hrabeCesnek/Diplomka2/README.md

# Diplomka
Nothing more than destiny fullfillation
