hrabeCesnek/Diplomka2/bp_dp.tex

% -----------------------------------------------
% Styl pro psaní diplomových a bakalářských prací
% -----------------------------------------------
\documentclass[a4paper,12pt]{book} % pro oboustranný tisk zvolte {book}!
% velikost stránky
\usepackage[tmargin=2cm,bmargin=2.5cm,rmargin=2cm,lmargin=3.5cm]{geometry}
% volba kódování, nastaveno je unicode
\usepackage[utf8]{inputenc}
% \usepackage[cp1250]{inputenc}
% \usepackage[latin2]{inputenc}
\usepackage[english]{babel}
%\def\refname{Literatura}
% pomocná makra pro sazbu matematických výrazů
\usepackage{amssymb} %na psaní dvojitých písem a zvlastních znaků (např. \varkappa)
\usepackage{amsmath}
% balíček pro vkládání obrázků
\usepackage{graphicx}
\usepackage{subfig}
% balíček pro obrázky na krajích stránky 
%\usepackage{floatflt}
% balíček pro křížové odkazy
\usepackage[unicode,bookmarksopen,colorlinks=false,plainpages=false,urlcolor=blue,pdfpagelabels]{hyperref}
% balíček pro vkládání hypertextových odkazů
\usepackage{url}
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
\ifbakal%
  \newcommand{\program}{B0533A110007  Applied Physics}%
  \newcommand{\obor}{1702R001  Applied Physics  (AFYZ)}%
  \else%
  \newcommand{\program}{N0533A110002 Applied Physics}%
  \newcommand{\obor}{1702T001 Applied Physics  (AFYZ)}%  

\fi
\newcommand{\rokod}{2024}
\newcommand{\vedouci}{Mgr. Aleš Stejskal Ph.D.}
\newcommand{\konzultant}{Mgr. Leo Schlattauer Ph.D.}

\newcommand{\abstrakt}{%
Tato práce je věnována vývoji polovodičového detektoru pro nízkoenergetické gamma fotony. Popisuje testování PIN fotodiod, vývoj analogových elektornických obvodů pro gamma a Mössbauerovu spektroskopii a taktéž se zabývá komparačními měřeními mezi polovodičovými detektory a jinými typy detektorů.}
% -----------------------------------------------
\newcommand{\abstrakten}{%
This thesis is dedicated to the development of
of semiconductor detectors for low energy gamma photons. It describes the testing of PIN photodiodes, the development of analog electronic circuits for the purposes gamma and Mössbauer spectroscopy and also deals with comparative measurements between semiconductor detectors and other types of detectors.}
% klíčová slova
\newcommand{\klic}{PIN fotodioda, PCB, MS, gamma spektrum, předzesilovač}
\newcommand{\klicen}{PIN photodiode, PCB, MS, gamma spectrum, preamplifier}
\newcommand{\pocetstran}{	
\pageref{LastPage}}
\newcommand{\pocetpriloh}{1}

% -----------------------------------------------
% Definice vlastních maker pro usnadnění psaní
% a opakování symbolů při zlomu řádku
% -----------------------------------------------
% implikace se opakuje
\def\Plyne{\Rightarrow\discretionary{}{\hbox{$\Rightarrow$}}{}}
% -----------------------------------------------
% ekvivalence se opakuje
\def\Ekviv{\Leftrightarrow\discretionary{}{\hbox{$\Leftrightarrow$}}{}}
% -----------------------------------------------
% % plus '+' se opakuje při zalomení řádku
\mathchardef\plus="202B
\mathcode`\+="8000
{\catcode`\+=\active
\gdef+{\plus\nobreak\discretionary{}{\hbox{$\plus$}}{}}}
% opakování - při zalomení řádku
\newsavebox{\minusbox}
\savebox{\minusbox}{\hbox{$-$}}
\def\aktivniminus #1{{\catcode`#1=13 \bgroup \uccode`~=`#1
\uppercase{\egroup\gdef~}{\mathminus\discretionary{}{\copy\minusbox}{}}}}
% % -----------------------------------------------
% % rovnitko '=' se opakuje
\def\aktivnirovnitko #1{{\catcode`#1=13 \bgroup \uccode`~=`#1
\uppercase{\egroup\gdef~}{\mathequal\discretionary{}{=}{}}}}
% -----------------------------------------------
% zrušení mezery za čárkou v matematickém reľimu
\mathcode`,="002C

% -----------------------------------------------
% Úprava matematické sazby
% -----------------------------------------------
\def\sgn{\mathop{\rm sgn}\nolimits}
\def\tg{\mathop{\rm tg}\nolimits}
\def\cotg{\mathop{\rm cotg}\nolimits}
\def\arctg{\mathop{\rm arctg}\nolimits}
% -----------------------------------------------
% vektory polotučným skloněným písmem
\DeclareFontFamily{OT1}{bssbf}{}
\DeclareFontShape{OT1}{bssbf}{m}{n}{<5> <6> <7> <8> <9> <10> <11> <12> <14.4> <17> <20> <20.74> <25> bssb10}{}
\newcommand{\vek}{\fontencoding{OT1}\fontfamily{bssbf}\selectfont}
\renewcommand{\vec}[1]{\hbox{\vek #1}\hspace*{1.5pt}}
% polotučná řecká písmena
\def\bgomega{\vec{\char151}}
     \def\bgOmega{\vec{\char10}}
     \def\bggamma{\vec{\char130}}
     \def\bgvarphi{\vec{\char161}}
     \def\bgphi{\vec{\char148}}
     \def\bgxi{\vec{\char142}}
     \def\bgtau{\vec{\char146}}
     \def\bgeta{\vec{\char134}}
     \def\bgmu{\vec{\char139}}
     \def\bgnu{\vec{\char140}}
     \def\bvarrho{\vec{\char157}}
     \def\bgsigma{\vec{\char145}}
     \def\bgpsi{\vec{\char150}}
     \def\bgchi{\vec{\char149}}
     \def\bgvartheta{\vec{\char154}}
%\renewcommand{\thefigure}{\arabic{figure}}
%\renewcommand{\theeuqation}{\arabic{euqation}}

\raggedbottom %přidaný kvůli špatnýmu řádkování
% ---------------------------------------------------------------
% Samotná práce
% ---------------------------------------------------------------
\begin{document}

% -----------------------------------------------
% Titulní strana
% -----------------------------------------------
\pagestyle{empty}
\setbox0=\hbox{\LARGE\scshape Joint Laboratory of Optics}
\centerline{\LARGE\scshape  Palacký University Olomouc}

\bigskip
\centerline{\LARGE\scshape Faculty of Science}
   
\bigskip
\centerline{\box0}
  
\vfill
\centerline{\LARGE\bfseries \ifbakal{BACHELOR}\else{MASTER}\fi\ THESIS}

\bigskip
\begin{center}
{\huge\nazev}  

\vfill
\ifbarva\else%
\fi

\vfill

\noindent%
\begin{tabular}{ll}
Author\ifstudentka{a}\fi: & {\bfseries\student}\\
Study program: &\program\\
Field of study: &\obor\\
Form of study:& Full-time\\
Supervisor:& \vedouci\\
Deadline:& May~\rokod
\end{tabular}
\end{center}
%----Vdek------------------------------------------------------
\newpage
\hbox{~}

\vfill
\noindent

I would like to thank my supervisor Mgr. Aleš Stejskal Ph.D. for his support, guidance and feedback during the whole process of writing this thesis. I would also like to thank my former supervisor Mgr. Leo Schlattauer Ph.D. for the necessary support at the very beginning of the work on the experimental part of this thesis.

% ---------------------------------------------------------------
% Prohlášení
% -----------------------------------------------
\newpage
\hbox{~}

\vfill

\begin{center}
{\bf DECLARATION}
\end{center}

\noindent
I hereby declare that I elaborated this master thesis independently under the supervision 
of Mgr. Aleš Stejskal Ph.D.,  using  only  information  sources  referred  in  the  Literature chapter. \\
{}\vspace{3ex}

\noindent
In~Olomouc~\today   \hfill\parbox[t]{6cm}{\centering\null\dotfill\\\student}

% -----------------------------------------------
% Bibliografická anotace
% -----------------------------------------------
\newpage
\input{bibl_identifikace}

%%%% Tady začínáme %%%%%%%%%%%%%%%%%%%%%%%%%%%%%%%%%%%%%%%%%%%%%%%%%%%%%%%%%%
\newpage
%%%%%%%%%%%%%%%%%%%%%%%%%%%%%%%%%%%%%%%%%%%%%%%%%%%%%%%%%%%%%%%%%%%%%%%%%%%%%
\widowpenalty =10000
\pagestyle{plain}
\let\cleardoublepage\clearpage %odstanění dvojitých stran
% -----------------------------------------------
% Obsah je generován automaticky, změny se projeví po 2 překladech
% -----------------------------------------------
\tableofcontents

% -----------------------------------------------
% Úvod
% -----------------------------------------------
\chapter*{Introduction}
\addcontentsline{toc}{chapter}{Introduction}
In nuclear and particle physics, semiconductor-based detectors are becoming increasingly common due to the many unique properties they offer. Semiconductor detectors have a very wide range of applications, from spectroscopy to large particle experiments such as ATLAS at CERN.  

\par
This thesis is dedicated to the development of a semiconductor detector based on a Si photodiode for the detection of low energy gamma photons. The detection of low-energy gamma photons plays a crucial role in the field of Mössbauer spectroscopy, which requires a detector with sufficient detection efficiency and energy resolution.
\par
The first four chapters are theoretical and provide a brief introduction to the mechanisms of gamma photon interaction and detection, the properties of semiconductor detectors and the basics of Mössbauer spectroscopy. These chapters are followed by a chapter describing the specifications of nuclear instruments used to build a spectrometric chain, and then a chapter introducing the numerical analysis of gamma energy spectra. 

\par
The experimental part begins with the gamma detection tests of selected photodiodes and is followed by a chapter filled with the technical description of the printed circuit board (PCB) integration of the spectrometric chain. The thesis ends with two chapters presenting the results of gamma energy spectra and Mössbauer spectra measurements.

% -----------------------------------------------
% Kapitoly lze ukládat do zvláštních souborů...
% -----------------------------------------------

% -----------------------------------------------
\input{gammaRays}

\input{detectors}

\input{Semiconductors}

\input{Mossbauer}

\input{pulseAnalysis}

\input{Algorytms}

\input{PINtesting}

\input{PCBconstruct}

\input{PCBmeas}

\input{MossMeas}

% -----------------------------------------------
% Závěr
% -----------------------------------------------
\chapter*{Discussion}
\addcontentsline{toc}{chapter}{Discussion}
The development of the PIN detector for transmission MS spectroscopy can be continued by using photodiodes with better detection efficiency - by using a Si photodiode with greater thickness or by using a photodiode made of another material with higher $Z$ (e.g. Ge). To fully observe the 6.4 keV energy peak, it will be necessary to use a photodiode with lower capacitance (greater thickness also implies lower capacitance) or a preamplifier with better characteristics. This optimised preamplifier can be realised using discrete opamps. The development can also be continued by mathematical modelling of a better semiconductor detector for MS and by a theoretical simulation of its detection efficiency, using some of the well-known programs for simulating the passage of particles through matter, such as the Geant4 \cite{Geant4}.
\par
The semiconductor detector with a larger detection area can be made up of several PIN photodiodes. However, to reduce noise, each photodiode must have its own preamplifier and amplifier. The final aim is to build a compact Mössbauer spectrometer for backscattering geometry by combining several Si PIN photodiodes with a small transducer in one instrument.
%The development of PIN detector for transmission MS spectroscopy can continue by employing the photodiodes with better detection efficiency - by using Si photodiode with greater thickness or by using a photodiode made of a different material with higher $Z$ (for example Ge). To fully observe 6.4 keV energy peak, it will be necessary to employ a photodiode with lesser capacitance (greater thickness also implies lesser capacitance) or a preamplifier with a better characteristics. The development can also go on by the mathematical modelling of a better semiconductor detector for MS and by a theoretical simulations of its detection efficiency by using some of well-known programs for the simulation of passage of particles through matter such as the Geant4 \cite{Geant4}.
%\par
%The semiconductor detector with greater detection area can be constructed from multiple PIN photodiodes. However, to reduce noise, it is necessary that each photodiode have its own preamplifier and amplifier. Final goal is then to assemble the compact Mössbauer spectrometer for backscattering geometry by combining multiple Si PIN photodiodes and a small transducer into one instrument.

\chapter*{Conclusion}
\addcontentsline{toc}{chapter}{Conclusion}
The first tests of the SI PIN photodiodes were performed on a setup consisting of ORTEC modular parts. All three selected photodiodes (S14605, BPW34 and OPF430) produced spectrometric pulses and the gamma spectra of $^{57}$Co were successfully measured and interpreted. Characteristic full energy peaks of $^{57}$Co (14.4 keV, 122.1 keV and 136.5 keV) were observed, as well as the expected Compton continuum resulting from Compton scattering of 122.1 keV inside the detector. It was found that electromagnetic shielding plays a very important role in noise reduction. The Si PIN photodiodes attached to the charge preamplifier cannot operate properly without sufficient shielding. Cooling the photodiode also had an effect, but it was much less significant.
\par
It was shown that even a cheap Si PIN photodiode (BPW34 and OPF430), originally designed for light detection, could be used as a detector for gamma spectroscopy. However, it has been shown that their detection efficiency is much lower than that of the S14605 photodiode, which is classified as an X-ray detector.
\par
The analog front-end electronics, based on the Cremat preamplifier and shaper, has been successfully developed. It requires only a +15V and -15V power supply to operate. Its output can be connected directly to the MCA. The MS measurement setup using the constructed Si PIN detector was successfully assembled and the transmission MS spectra of a singlet sample were successfully measured.
\par
Two types of measurements were performed to compare the Si PIN detector with the gas and scintillator detector - the 14.4 keV relative detection efficiency measurement and the MS measurement. The only parameter of the Si PIN detector that can be characterised as the best among the detectors tested is the effect of the measurement.
%The first tests of Si PIN photodiodes were performed on setup consisting of ORTEC modular parts. All the three selected photodiodes (S14605, BPW34 and OPF430) produced spectrometric pulses and the gamma spectra of $^{57}$Co were successfully measured and interpreted. Characteristic full energy peaks of $^{57}$Co (14.4 keV, 122.1 keV and 136.5 keV) were observed as well as expected Compton continuum originating from Compton scattering of 122.1 keV inside the detector. It was found out, that the electromagnetic shielding plays a very important role in noise reduction. The Si PIN  photodiodes attached to charge preamplifier can not work properly without sufficient shielding. Cooling the photodiode also had an effect, but its significance was much lower.
%\par
%It was proven, that even a cheap Si PIN photodiode (BPW34 and OPF430) originally intended for detection of light can be employed as detector for gamma spectroscopy. However, it was shown that their detection efficiency is much worse than the detection efficiency of photodiode S14605, which is classified as X-ray detector.
%\par
%The front-end analog electronics based on Cremat preamplifer and shaper was successfully developed. For its functionality it requires only +15 V and -15 V power supply. Its output can be directly routed to the MCA. The MS measurement setup employing constructed Si PIN detector was successfully assembled and the transmission MS spectra of a singlet sample was successfully measured.
%\par
%Two types of measurements were performed in order to compare the Si PIN detector with gaseous and scintillator detector - the measurement of 14.4 keV realative detection efficiency and the MS measurement. The only parameter of the Si PIN detector, which can be characterized as the best among the tested detectors is effect of measurement.

% -----------------------------------------------
% Literatura a prameny
% -----------------------------------------------
%\begin{thebibliography}{99}
%\bibliographystyle{unsrt}
%\nocite{*}
%\bibliography{citations}
%\nocite{MALACARI2020102430}
%\nocite{*}
%\nocite{Tomankova2016_1000061954}
%\nocite{VACULA2021167169}
%\addcontentsline{toc}{chapter}{Literatura}
%\bibitem{gravitation} MISNER, Ch. W.; THORNE, K. S.; WHEELER, J. A. %\emph{Gravitation}. San Francisco: W. Freeman, 1973.
%\end{thebibliography}
%\printbibliography
\printbibliography[notcategory=skipbibliography]
%\newpage
%\chapter*{Attachment: Measurement and analysis programs}
%Measurement folder - scripts for controlling measurement
%\newline
%PulseAnalysis folder - scripts for PMT pulse analysis
%\newline
%FASTanalyze.cpp - calibration data analysis
%\newline
%main.c - Nucleo F446RE's synchronized sampling and PID regulator firmware
\chapter*{List of Symbols and Abbreviations}
\begin{table}[H]
\begin{tabular}{l l}
$\sigma$ & cross section \\
$\sigma_{\textrm{A}}$ & cross section of single atom \\
$F_{\textrm{part}}$ & particle flux \\
$N_{\textrm{s}}$ & average number of particles scattered per unit time from single point target \\
$\Omega$ & solid angle\\
$A$ & area perpendicular to the flux\\
$N_{\textrm{i}}$ & density of interaction centres \\
$N_{\textrm{sc}}(\Omega)$ & average number of particles scattered per unit time multiple interaction centres \\
$N_{\textrm{tot}}$ & average number of particles scattered per unit time multiple interaction centres \\
& integrated over entire solid angle \\
$\delta x$ & material thickness \\
$Z$ & atomic number \\
$I_{\textrm{T}}$ & transmitted radiation intensity\\
$I_{\textrm{0}}$ & incident radiation intensity\\
$\mu$ & total absorption coefficient\\
$N_{\textrm{d}}$ & atomic density \\
$N_{\textrm{a}}$ & Avogadro number \\
$\rho$ & material density \\
$A_{\textrm{w}}$ & molecular weight \\
$f$ & photon frequency \\
$h$ & Planck's constant \\
$\hbar$ & reduced Planck's constant \\
$E_{\textrm{e}}$ & kinetic energy of free electron \\
$E_{\textrm{b}}$ & binding energy of electron \\
$E_{\textrm{2}}$ & scattered photon energy \\
$E_{\textrm{1}}$ & initial photon energy \\
$m_{\textrm{e}}$ & electron mass \\
$M$ & heavy charged particle mass \\
$c$ &  speed of light in vacuum\\
$\frac{dE}{dx}$ &  stopping power\\
$\theta$ &  scattering angle \\
$\varphi$ &  maximum scattering angle \\
$E_{\textrm{c}}$ & energy of electron inside crystal\\
$E_{\textrm{c}}(\vec{k})$ & energy dispersion relation\\
$\vec{k}$ & wave vector \\
$E_{\textrm{g}}$ & energy gap\\
$E_{\textrm{T}}$ & thermal energy\\
$E_{\textrm{s}}$ & electrostatic energy\\
$E_{\textrm{photon}}$ & photon energy\\

\end{tabular}
 \label{symbols}
\end{table}

\newpage
\begin{table}[H]
\begin{tabular}{l l}
$E_{\textrm{F}}$ & Fermi level energy\\
$k$ & Boltzmann constant\\
$\phi$ & electrostatic potential\\
$T$ & thermodynamic temperature \\
$t$ & temperature (Celsius scale)\\
$\omega_{\textrm{photon}}$ & photon angular frequency \\
$E_{\textrm{gamma}}$ & incident gamma photon energy \\
$\epsilon$ & average energy for electron-hole pair generation \\
$n$ & number of generated electron-hole pairs \\
$E$ & energy of incoming particle \\
$F$ & Fano factor \\
$U_{\textrm{R}}$ & reverse voltage \\
$E_{\textrm{0}}$ & base energy level of nucleus\\
$E_{\textrm{M}}$ & pertubed energy level of nucleus\\
$Q_{\textrm{n}}$ & quadrupole momentum of nucleus\\
$m$ & nuclear magnetic number\\
$I_{\textrm{n}}$ & spin of nucleus\\
$E_{\textrm{Q}}$ & energy variation with respect to magnetic quantum number\\
$\gamma$ & gyromagnetic ratio\\
$\delta$ & isomer shift\\
$\mu_{\textrm{m}}$ & magnetic momentum of nucleus\\
$L_{\textrm{v}}$ & Lorentzian in MS spectrum\\
$v$ & relative velocity of radiation source and MS sample \\
$v_0$ & resonant velocity \\
$A$ & area under Lorentzian \\
$\Gamma$ & FWHM of Lorentzian\\
$I_{\textrm{MS}}$ & amplitude of Lorentzian\\
$B$ & MS background level \\
$E_{\textrm{MS}}$ & MS effect of measurement \\
SNR$_{\textrm{MS}}$ & MS signal to noise ratio \\
$Q$ & charge \\
$U$ & voltage \\
$I$ & current \\
$I_{\textrm{G}}$ & FET gate current \\
$I_{\textrm{D}}$ & dark current \\
$C_{\textrm{f}}$ & feedback capacitance \\
$R_{\textrm{f}}$ & feedback resistance \\
$G$ & gain \\
$en_{1}$ & thermal noise of the first stage FET \\
$en_{2}$ & thermal noise caused by feedback resistance \\
$in$ & shot noise \\
$noise$ & total noise \\
$\omega$ & signal angular frequency\\
$j$ & complex unit \\
$g_{\textrm{m}}$ & FET transconductance \\
$\tau$ & decay constant\\
$U_{\textrm{A}}$ & pulse amplitude\\
$C_{\textrm{in}}$ & input capacitance \\
$C_{\textrm{j}}$ & detector capacitance \\

\end{tabular}
 \label{symbols2}
\end{table}

\newpage
\begin{table}[H]
\begin{tabular}{l l}

$C_{\textrm{s}}$ & amplifier input capacitance \\
$d$ & collimator diameter \\
$I_{\textrm{rec}}$ & recalculated amplitude of Lorentzian\\
$I_{\textrm{original}}$ & original amplitude of Lorentzian\\
$\Gamma_{\textrm{ref}}$ & original FWHM of Lorentzian\\
FWHM$_{\textrm{CR-100}}$ & FWHM limit given by CR-110 \\
FWHM$_{14.4}$ & FWHM of the 14.4 keV peak \\
FWHM$_{\textrm{Fano}}$ & FWHM given by fano noise \\

\end{tabular}
 \label{symbols3}
\end{table}

\begin{table}[H]
\begin{tabular}{l l}

PCB & printed circuit board \\
SNR & signal to noise ratio \\
PMT & photomultiplier tube \\
DEP & Department of Experimental Physics \\
MCA & multichannel analyser \\
APD & avalanche photodiode \\
CCD & charge-coupled device\\
CMOS & complementary metal–oxide–semiconductor\\
FWHM & full width at half maximum\\
GND & ground\\
YAP(Ce) & yttrium aluminium perovskite dopped by cerium\\
MS & Mössbauer spectroscopy\\
MPC & model predictive control \\
PID & proportional–integral–derivative\\

\end{tabular}
 \label{shorts}
\end{table}

\chapter*{Appendix}
\section*{Schematic and layout of the integrated amplifier}
Full EAGLE schematic and layout are in the folder IntegratedAmplifier. 

\begin{figure}[H]
 \centering
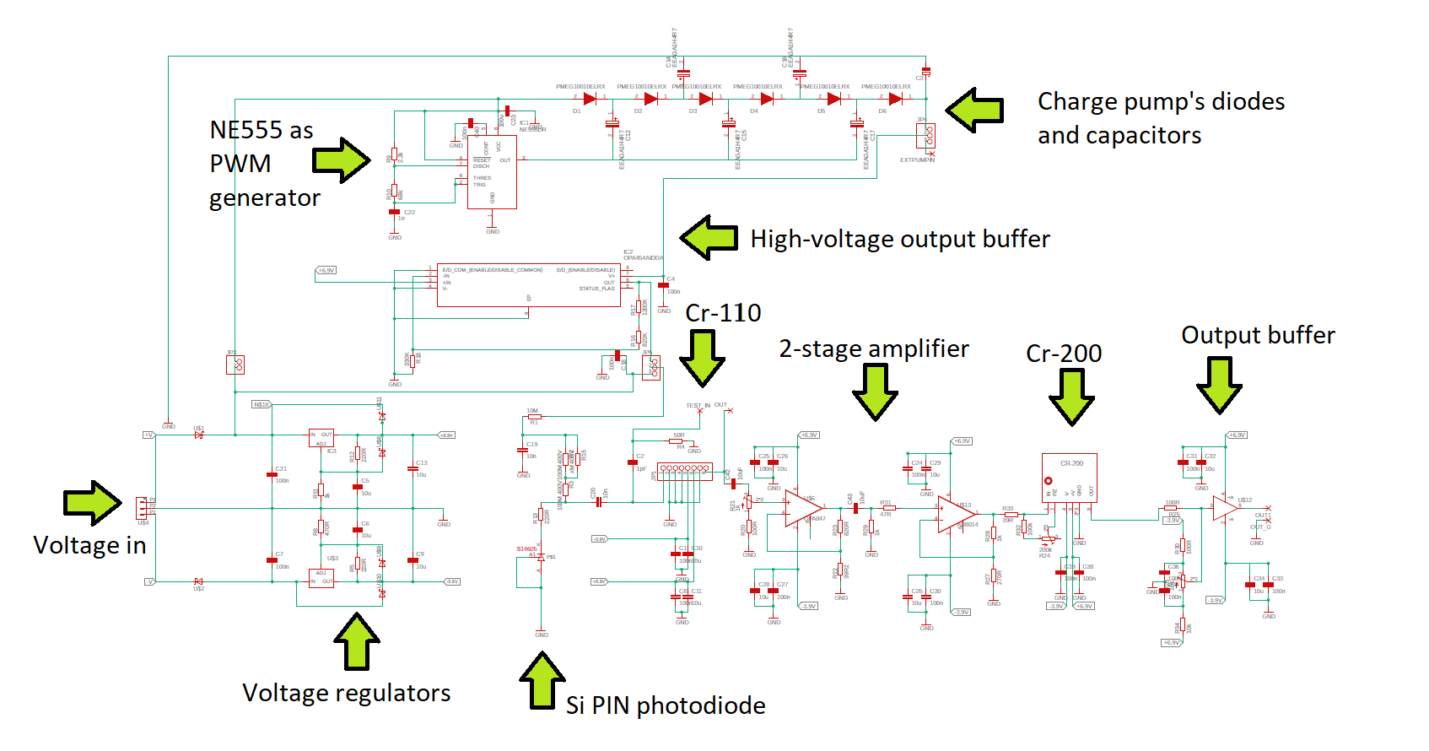
[picture p1: pictures/schemaPopis.png]
 
 \caption*{Schematic of integrated amplifier.}
 \label{schematic}
 
\end{figure}

\begin{figure}[H]
 \centering
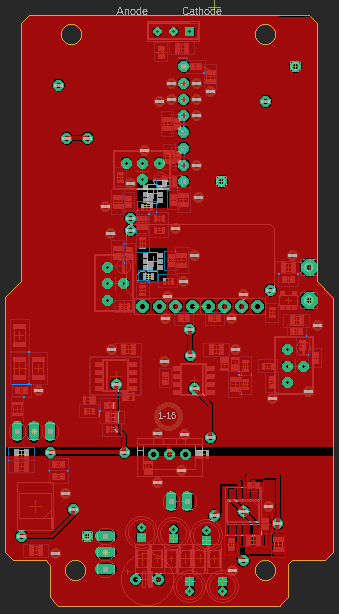
[picture p2: pictures/S14topLay.png]
 
 \caption*{Layout of integrated amplifier, top side layer.}
 \label{layout top}
 
\end{figure}

\begin{figure}[H]
 \centering
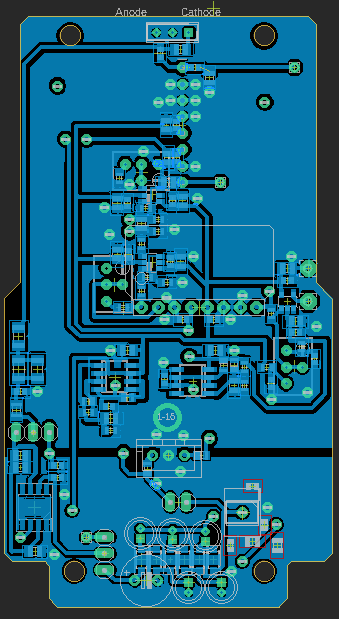
[picture p3: pictures/S14bottomLay.png]
 
 \caption*{Layout of integrated amplifier, bottom side layer.}
 \label{layout bottom}
 
\end{figure}

\section*{Peak searching program}
File SpectreAnalyzer.cpp: C++ program for automatic searching of peaks in spectrum.

\end{document}
% Konec souboru %%%%%%%%%%%%%%%%%%%%%%%%%%%%%%%%%%%%%%%%%%%%%%%%%%%%%%%%%%%%
