hrabeCesnek/Diplomka2/bibl_identifikace.tex

% Bibliografická identifikace
\section*{Bibliografická identifikace}

\begin{tabular}{lp{8.5cm}}
%-----------
% \multicolumn{2}{c}{\bfseries Bibliografická identifikace}\\[8mm]
%-----------
Jméno a příjmení autora & \student\\
%-----------
Název práce & \nazevcz \\
%-----------
Typ práce & \ifbakal{Bakalářská}\else{Diplomová}\fi \\
%-----------
Pracoviště & Společná laboratoř optiky \\
%-----------
Vedoucí práce & \vedouci\\
%-----------
Konzultant & \konzultant\\
%-----------
Rok obhajoby práce & \rokod\\
%-----------
Abstrakt & \abstrakt\\
%-----------
Klíčová slova & \klic\\
%-----------
Počet stran & \pocetstran\\
%-----------
Počet příloh & \pocetpriloh\\
%-----------
Jazyk & anglický\\
%-----------
\end{tabular}

% -----------------------------------------------

\newpage
\section*{Bibliographical identification}

\begin{tabular}{lp{8cm}}
%-----------
% \multicolumn{2}{c}{\bfseries Bibliographical identification}\\[8mm]
%-----------
Autor's first name and surname & \student\\
%-----------
Title & \nazev\\
%-----------
Type of thesis & \ifbakal{Bachelor}\else{Master}\fi \\
%-----------
Department & Joint Laboratory of Optics \\
%-----------
Supervisor & \vedouci\\
%-----------
Consultant & \konzultant\\
%-----------
The year of presentation & \rokod \\
%-----------
Abstract & \abstrakten\\
%-----------
Keywords & \klicen\\
%-----------
Number of pages & \pocetstran\\
%-----------
Number of appendices &  \pocetpriloh\\
%-----------
Language & english\\
%-----------
\end{tabular}
% %%%%%%%%%%%%%%%%%%%%%%%% End of file %%%%%%%%%%%%%%%%%%%%%%%%
