hrabeCesnek/Diplomka2/bibl_identifikaceORIG.tex

% Bibliografická identifikace
\section*{Bibliografická identifikace}

\begin{tabular}{lp{8.5cm}}
%-----------
% \multicolumn{2}{c}{\bfseries Bibliografická identifikace}\\[8mm]
%-----------
Jméno a příjmení autora & \student\\
%-----------
Název práce & \nazev \\
%-----------
Typ práce & \ifbakal{Bakalářská}\else{Diplomová}\fi \\
%-----------
Pracoviště & Katedra experimentální fyziky \\
%-----------
Vedoucí práce & \vedouci\\
%-----------
Rok obhajoby práce & \rokod\\
%-----------
Abstrakt & \abstrakt\\
%-----------
Klíčová slova & \klic\\
%-----------
Počet stran & \pocetstran\\
%-----------
Počet příloh & \pocetpriloh\\
%-----------
Jazyk & český\\
%-----------
\end{tabular}

% -----------------------------------------------
\newpage
\section*{Bibliographical identification}

\begin{tabular}{lp{8cm}}
%-----------
% \multicolumn{2}{c}{\bfseries Bibliographical identification}\\[8mm]
%-----------
Autor's first name and surname & \student\\
%-----------
Title & \nazeven\\
%-----------
Type of thesis & \ifbakal{Bachelor}\else{Master}\fi \\
%-----------
Department & Department of Experimental Physics \\
%-----------
Supervisor & \vedouci\\
%-----------
The year of presentation & \rokod \\
%-----------
Abstract & \abstrakten\\
%-----------
Keywords & \klicen\\
%-----------
Number of pages & \pocetstran\\
%-----------
Number of appendices &  \pocetpriloh\\
%-----------
Language & czech\\
%-----------
\end{tabular}
% %%%%%%%%%%%%%%%%%%%%%%%% End of file %%%%%%%%%%%%%%%%%%%%%%%%
