hrabeCesnek/Diplomka2/other materials/sensors overview.ods

type | Type | Area [mm] | Reverse voltage [V] | Depletion layer [mm] | Dark current [nA] | Capacitance [pF]
S13993 | Direct PIN | 10x10 | 100 | 0.3 | 2 | 60
S14605 | Direct PIN | 9x9 | 70 | 0.5 | 8 | 40
S8559 | Scintillator CsI | 5.8x5.8 | 5 | - | 0.05 | 950
S8193 | Scintillator CsI | 5.8x5.8 | 5 | - | 0.05 | 950
