hrabeCesnek/Diplomka2/up_logo_bw.pdf

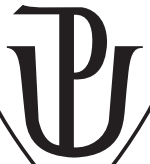
[picture p34: figure]
