hrabeCesnek/Diplomka2/up_logo_color.pdf

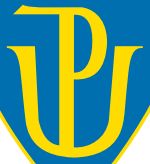
[picture p35: figure]
