hrabeCesnek/Diplomka2/pictures/chlazeniLedem.jpg

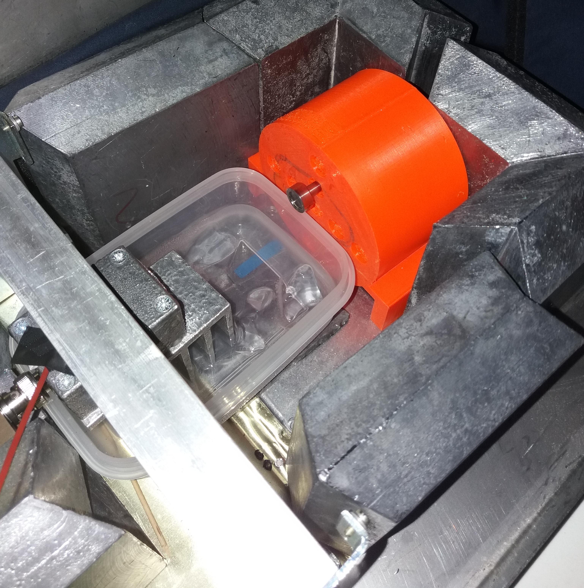
pictures/chlazeniLedem.jpg
