hrabeCesnek/Diplomka2/pictures/GASdet.png

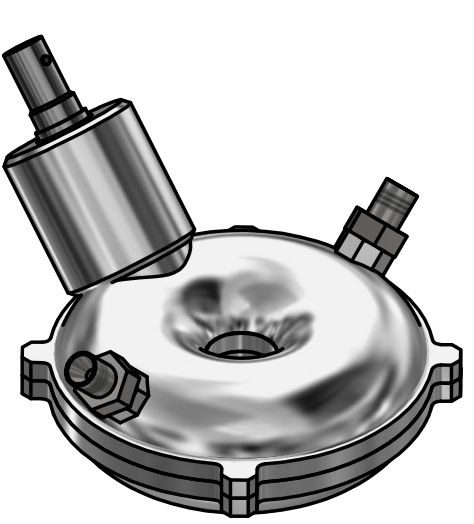
pictures/GASdet.png
