hrabeCesnek/Diplomka2/pictures/linearAttenuation.png

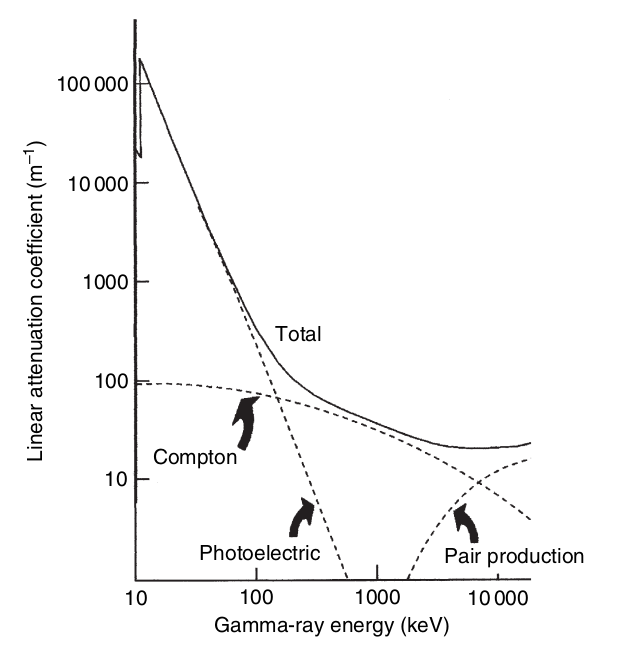
pictures/linearAttenuation.png
