hrabeCesnek/Diplomka2/pictures/PINdiodes.jpg

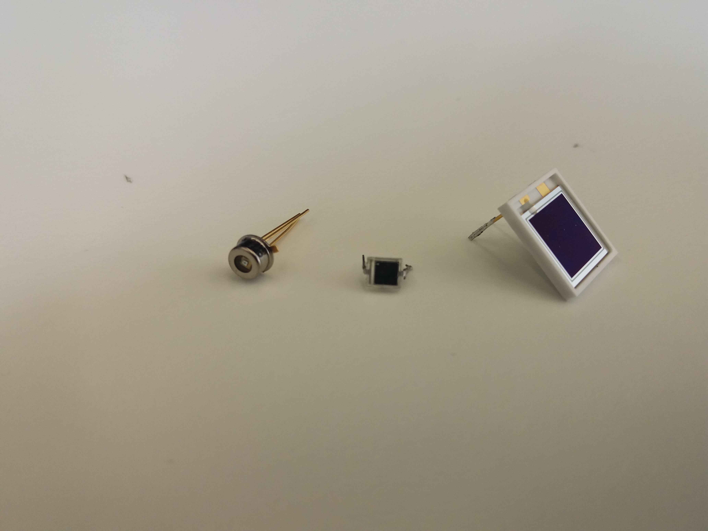
pictures/PINdiodes.jpg
