hrabeCesnek/Diplomka2/pictures/schema.png

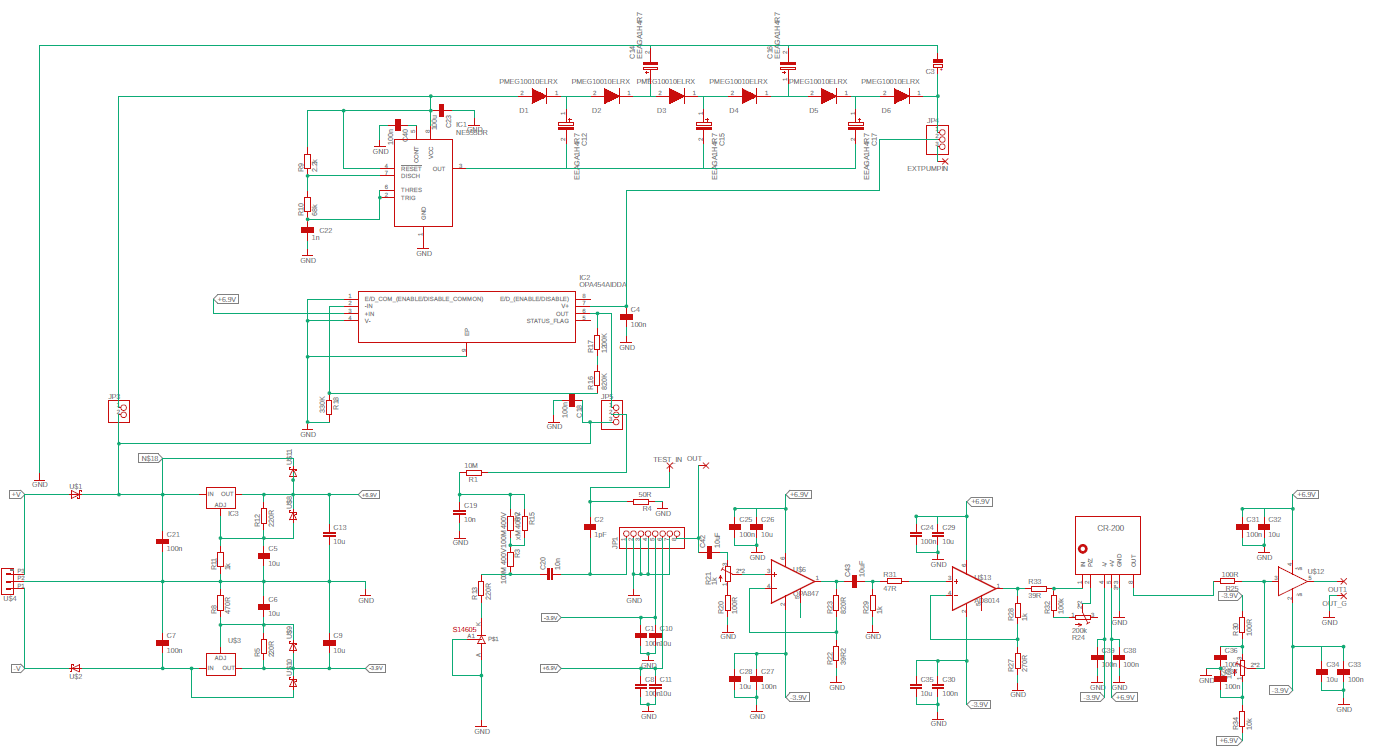
pictures/schema.png
