hrabeCesnek/Diplomka2/pictures/trash/DataGraph.png

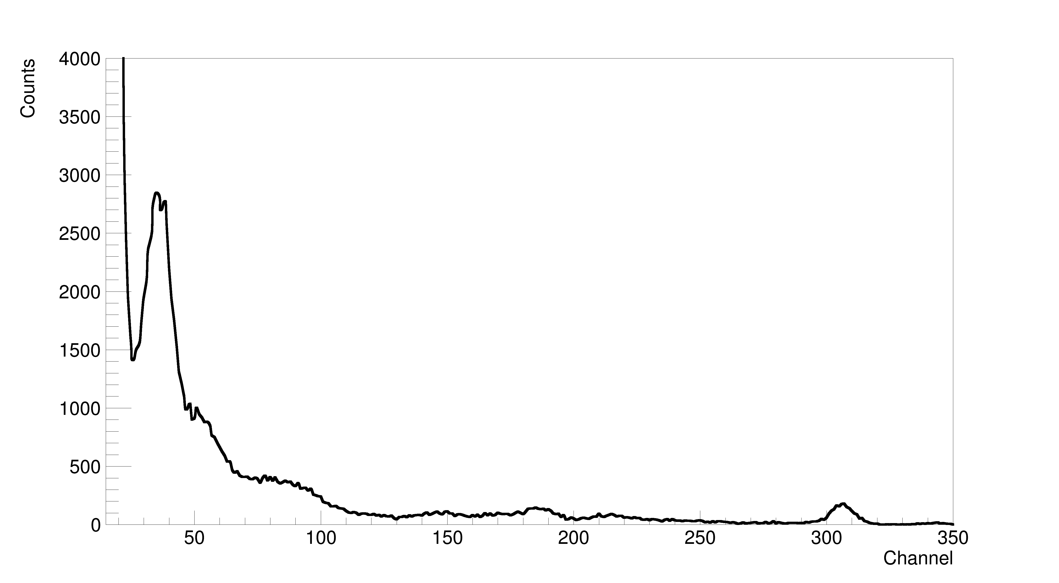
pictures/trash/DataGraph.png
