hrabeCesnek/Diplomka2/pictures/trash/SecondDerivGraph.png

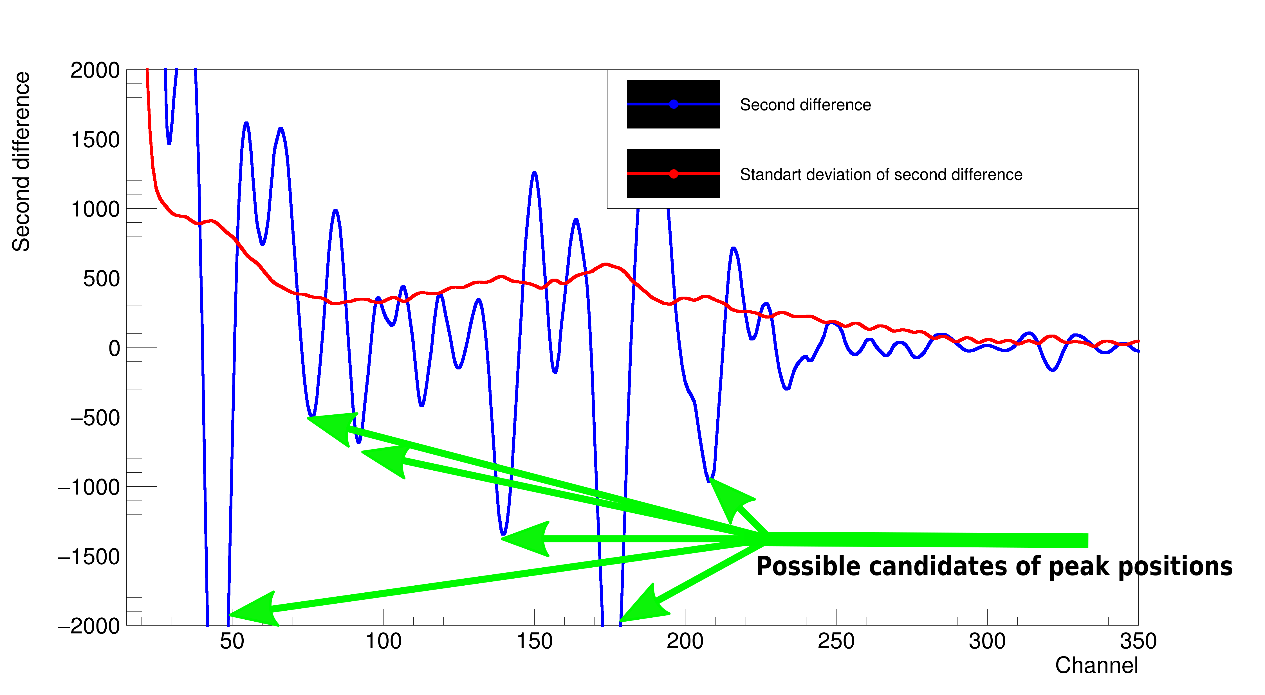
pictures/trash/SecondDerivGraph.png
