hrabeCesnek/Diplomka2/experiment.tex

% -----------------------------------------------
% Vlastní text práce (kapitoly práce)
% -----------------------------------------------

% -----------------------------------------------
\chapter{Semiconductor Detectors}
% -----------------------------------------------

\section{Principle and parameters}
\section{Construction scheme of Instruments for gamma detection based on semiconductors}

\subsection{XR-100CdTe X-Ray and Gamma Ray Detector}

\subsection{MIMOS 2}

\section{Available semiconductor sensors}

\section{Hamamatsu detectors}

\section{OPF420 PIN diode}

% %%%%%%%%%%%%%%%%%%%%%%%% End of file %%%%%%%%%%%%%%%%%%%%%%%%
