hrabeCesnek/Diplomka2/appendix/IntegratedAmplifier/S14FullAmpV2.brd

## EAGLE design appendix/IntegratedAmplifier/S14FullAmpV2.brd (2024-05-14)

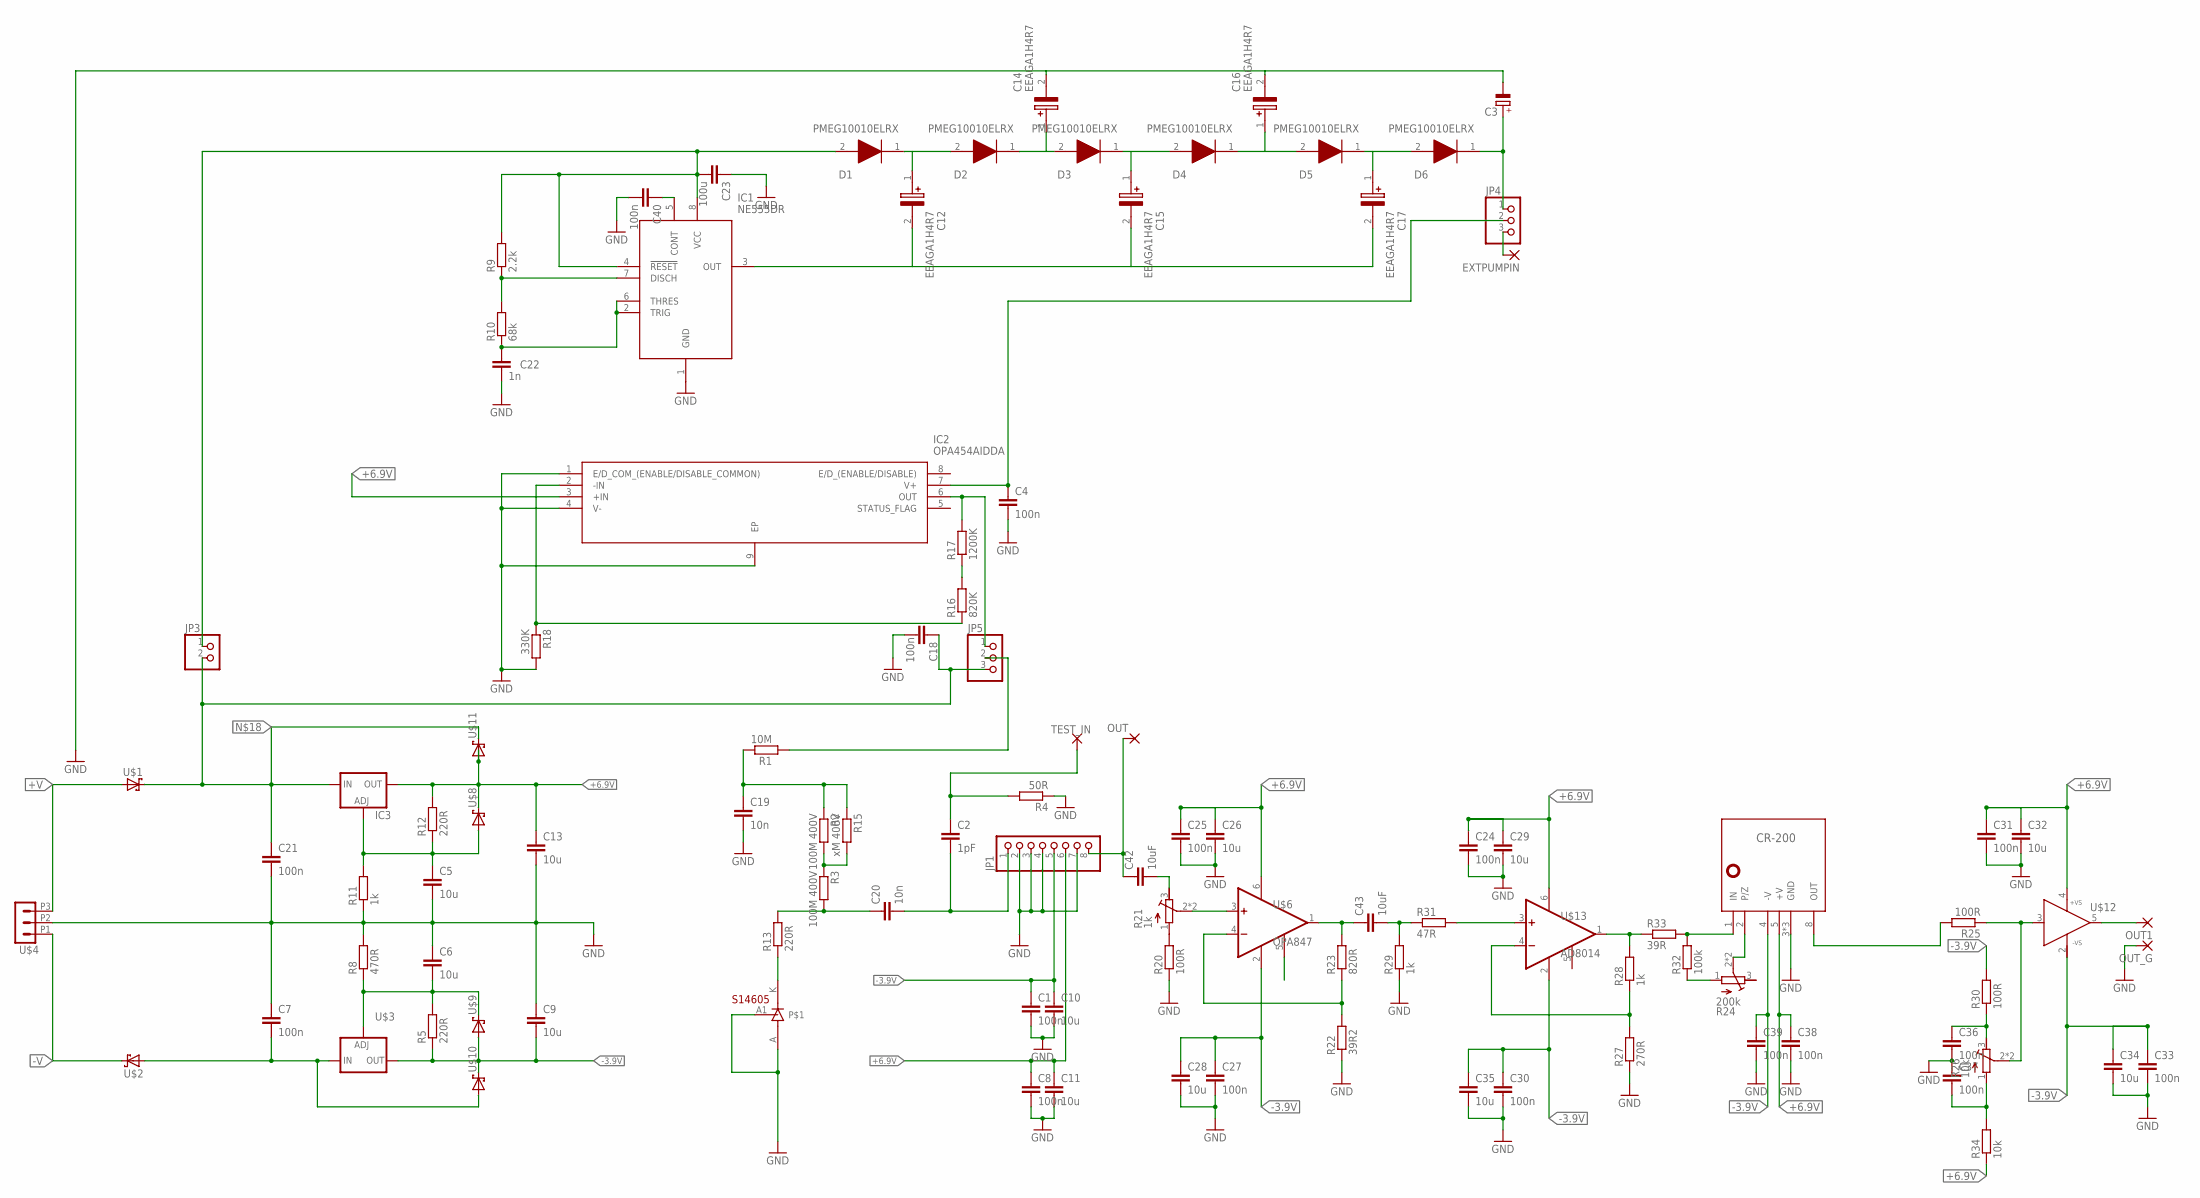
[picture p43: schematic S14FullAmpV2.sch]

Parts:
C1, C4, C7, C8, C18, C21, C24, C25, C27, C30, C31, C33, C36, C37, C38, C39, C40: 100n; C0603
C2: 1pF; C0603
C3: CPOL-EUE3.5-8; E3,5-8
C5, C6, C9, C10, C11, C13, C26, C28, C29, C32, C34, C35: 10u; C0805
C12, C14, C15, C16, C17: EEAGA1H4R7; CAPPRD150W50D400H800
C19, C20: 10n; C0603
C22: 1n; C0603
C23: 100u; C0603
C42, C43: 10uF; C0805
CR-200: CR-200H; CR-XXX-H
D1, D2, D3, D4, D5, D6: PMEG10010ELRX; SODFL3517X110N
EXTPUMPIN: 1,6/0,9
IC1: NE555DR; SOIC127P600X175-8N
IC2: OPA454AIDDA; SOIC127P600X170-9N
IC3: LM317; SO-08
JP1: HEADER-1X8ROUND; 1X08_ROUND
JP3: PINHD-1X2; 1X02
JP4, JP5: PINHD-1X3; 1X03
OUT: 1,6/0,9
OUT1: 2,54/0,9
OUT_G: 2,54/0,9
R1: 10M; M0805
R2, R3: 100M 400V; M1206
R4: 50R; R0805
R5, R12: 220R; R0603
R8: 470R; R0603
R9: 2.2k; R0805
R10: 68k; R0805
R11, R28, R29: 1k; R0603
R13: 220R; R0805
R15: xM 400V; M1206
R16: 820K; R0805
R17: 1200K; R0805
R18: 330K; R0805
R20, R25, R30: 100R; R0603
R21: 1k; RTRIM3299W
R22: 39R2; R0603
R23: 820R; R0603
R24: 200k; RTRIM3299W
R26: 10k; RTRIM3299W
R27: 270R; R0603
R31: 47R; R0603
R32: 100k; R0603
R33: 39R; R0603
R34: 10k; R0603
S1: S14605; RHDR3W53P0X254_1X3_762X246X425
TEST_IN: 1,6/0,9
U$1, U$2, U$8, U$9, U$10, U$11: BAS383; MICROMELF-R
U$3: LM337-SO8; SO8
U$4: XHT03T; XHT03
U$6: OPA847; SOT23-6
U$12: MAX4201; SOT23-5
U$13: AD8014; SOT23-6

Connections:
+6.9V: C8.1, C11.1, C13.1, C24.1, C25.1, C26.1, C29.1, C31.1, C32.1, C38.1, CR-200.5 (+V), IC2.3 (+IN), IC3.2 (OUT), IC3.3 (OUT), IC3.6 (OUT), IC3.7 (OUT), JP1.6, R12.2, R34.1, U$6.6 (V+), U$8.C, U$11.A, U$12.4 (+VS), U$13.6 (V+)
+V: U$1.A, U$4.P3 (3)
-3.9V: C1.1, C9.2, C10.1, C27.1, C28.1, C30.1, C33.1, C34.1, C35.1, C39.1, CR-200.4 (-V), JP1.5, R5.1, R30.2, U$3.1 (OUT), U$6.2 (V-), U$9.A, U$10.C, U$12.2 (-VS), U$13.2 (V-)
-V: U$2.C, U$4.P1 (1)
GND: C1.2, C3.-, C4.2, C5.2, C6.1, C7.1, C8.2, C9.1, C10.2, C11.2, C13.2, C14.2 (-), C16.2 (-), C18.2, C19.2, C21.2, C22.2, C23.1, C24.2, C25.2, C26.2, C27.2, C28.2, C29.2, C30.2, C31.2, C32.2, C33.2, C34.2, C35.2, C36.2, C37.1, C38.2, C39.2, C40.2, CR-200.3 (GND), CR-200.6 (GND), CR-200.7 (GND), IC1.1 (GND), IC2.1 (E/D_COM_(ENABLE/DISABLE_COMMON)), IC2.4 (V-), IC2.9 (EP), JP1.2, JP1.3, JP1.4, JP1.7, OUT_G.1, R4.1, R8.2, R11.1, R18.2, R20.1, R22.1, R27.1, R29.1, S1.A (ANODE), S1.A1, U$4.P2 (2)
unnamed: C19.1, R1.2, R2.1, R15.1
unnamed: JP5.2, R1.1
unnamed: R2.2, R3.1, R15.2
unnamed: C20.1, R3.2, R13.2
unnamed: C2.2, C20.2, JP1.1
unnamed: C2.1, R4.2, TEST_IN.1
unnamed: C42.1, JP1.8, OUT.1
unnamed: R24.1 (A), R32.1
unnamed: EXTPUMPIN.1, JP4.3
unnamed: C23.2, D1.2 (A), IC1.4 (!RESET), IC1.8 (VCC), JP3.1, R9.2
unnamed: C6.2, R5.2, R8.1, U$3.4 (ADJ), U$9.C
unnamed: R13.1, S1.K (KATHODE)
unnamed: C5.1, IC3.4 (ADJ), R11.2, R12.1, U$8.A
unnamed: R16.2, R17.1
unnamed: C12.1 (+), D1.1 (K), D2.2 (A)
unnamed: C12.2 (-), C15.2 (-), C17.2 (-), IC1.3 (OUT)
unnamed: C18.1, C21.1, IC3.1 (IN), JP3.2, JP5.3, U$1.C, U$11.C
unnamed: C14.1 (+), D2.1 (K), D3.2 (A)
unnamed: C40.1, IC1.5 (CONT)
unnamed: C3.+, D6.1 (K), JP4.1
unnamed: C15.1 (+), D3.1 (K), D4.2 (A)
unnamed: C16.1 (+), D4.1 (K), D5.2 (A)
unnamed: R20.2, R21.1 (A)
unnamed: C17.1 (+), D5.1 (K), D6.2 (A)
unnamed: C42.2, R21.3 (E)
unnamed: IC1.7 (DISCH), R9.1, R10.2
unnamed: C22.1, IC1.2 (TRIG), IC1.6 (THRES), R10.1
unnamed: IC2.6 (OUT), JP5.1, R17.2
unnamed: IC2.2 (-IN), R16.1, R18.1
unnamed: R22.2, R23.1, U$6.4 (-IN)
unnamed: R21.2 (S), R21.4 (S), U$6.3 (+IN)
unnamed: R25.1, R26.2 (S), R26.4 (S), U$12.3 (IN)
unnamed: OUT1.1, U$12.5 (OUT)
unnamed: R27.2, R28.1, U$13.4 (-IN)
unnamed: CR-200.1 (IN), R32.2, R33.2
unnamed: R31.2, U$13.3 (+IN)
unnamed: C36.1, R26.3 (E), R30.1
unnamed: CR-200.2 (P/Z), R24.2 (S), R24.4 (S)
unnamed: C43.1, R23.2, U$6.1 (OUT)
unnamed: C43.2, R29.2, R31.1
unnamed: C4.1, IC2.7 (V+), JP4.2
unnamed: R28.2, R33.1, U$13.1 (OUT)
unnamed: C37.2, R26.1 (A), R34.2
unnamed: CR-200.8 (OUT), R25.2
SH: U$13.5 (SH)
V-: C7.2, U$2.A, U$3.2 (IN), U$3.3 (IN), U$3.6 (IN), U$3.7 (IN), U$10.A

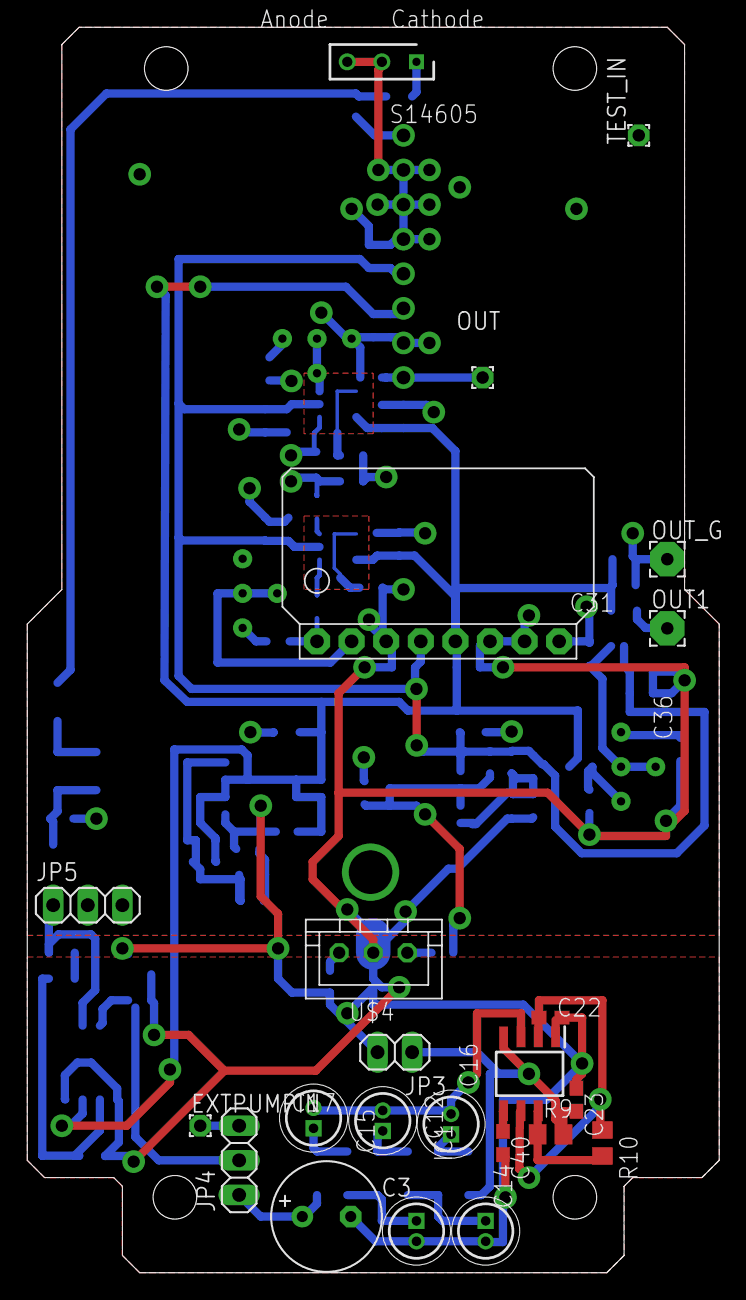
[picture p44: board S14FullAmpV2.brd from above]

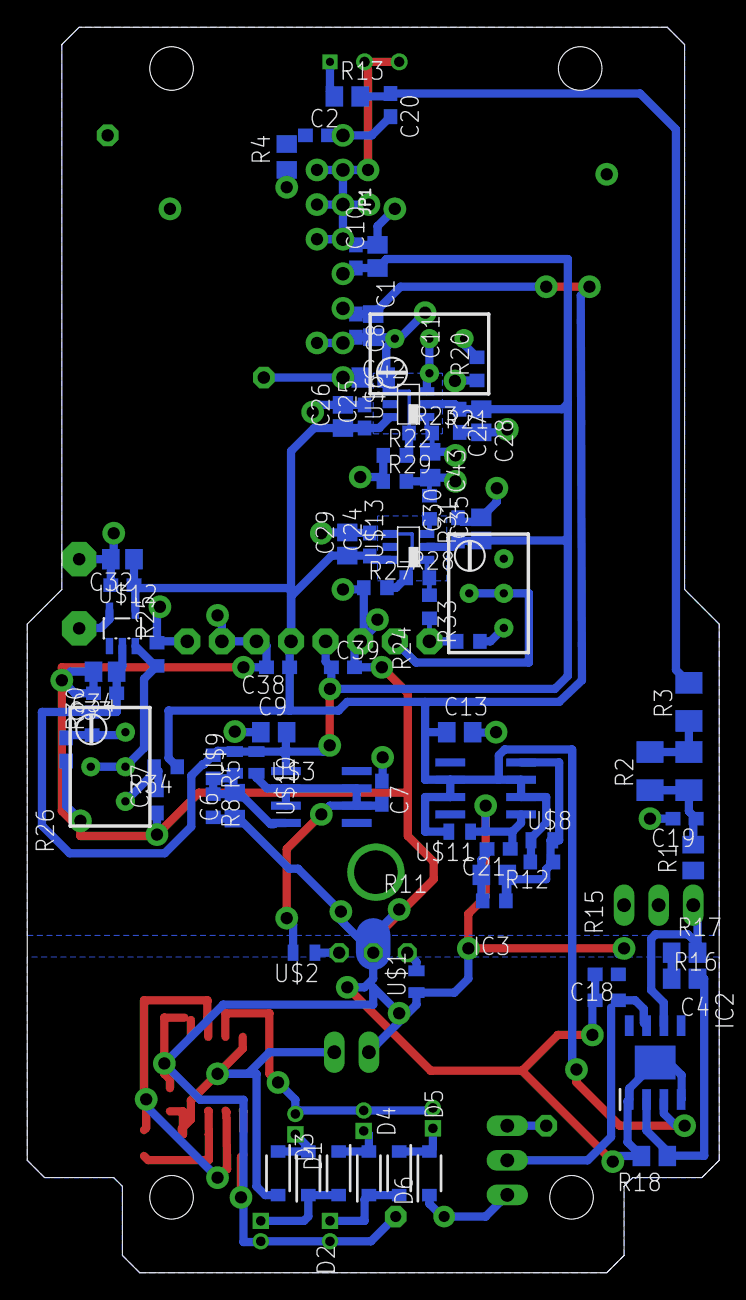
[picture p45: board S14FullAmpV2.brd from below]

Board: 2 copper layers, 50.8 x 91.4 mm, 103 parts (80 on the bottom side), 50 nets.
